shekratul10/EEProject/README.md

# Group 5/ASHB's EE Project 2022 

## [Written report](https://imperiallondon-my.sharepoint.com/:w:/g/personal/an521_ic_ac_uk/EeuObOR-S-lHpdSKYnU6FhYBMaKFVtId1mpSv_Idt-HmbQ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)
## [project mark scheme](https://github.com/shekratul10/EEProject/blob/main/Written%20report/EDP%20-%20final%20report%20mark%20sheet%202022%20-%20Copy.xlsx)
## [Video](https://imperiallondon-my.sharepoint.com/:v:/g/personal/eperea_ic_ac_uk/EdCU5DJ8DUpJqPFEcV0eLp4B5TmBCVaoO-RB1G3f6M7Cjg)
## [Video Demo](https://imperiallondon-my.sharepoint.com/:v:/g/personal/rs2221_ic_ac_uk/EedtrnN3LAxCjQFRvVvkyTYB7NkDGX7jUrfwkagcI3mQWg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)

## User Interface


## Important 
- Make component orders at https://apps.powerapps.com/play/30b4e212-d040-4203-98cc-882acb4edee0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 if necessary
- **We should wear suits or other formal wear to the demo for 24/06/22**
- Be aware that digital pins 5,7 & 10 cannot be used on the Adafruit board

The following needs to be **accomplished** to meet our project goals:
- [x] Develop a circuit to detect acoustic signals and analyse the frequency
- [x] Develop a circuit to detect infrared pulses and analyse the pulse frequency
- [x] Develop a circuit to detect magnetic field polarity and analyse the direction of the field
- [x] Develop a circuit to detect radio waves, detect the carrier frequency, detect the modulating frequency and analyse these frequencies
- [x] Establish motor control of the EEE Rover
- [x] Establish a web interface to control the motion of the EEE Rover as well as display the data gathered from the sensors
- [x] Consider CAD-based methods to improve the design of the EEE Rover
- [x] Conduct testing for each sensor and motor control
- [x] Produce a written report for each section, combine the reports and edit the combined document
- [x] Review the combined written report for final adjustments
- [x] Submit the final written report

## Useful information
Mineral properties:


Exorock operating switches:



## Acoustic sensing
Resources have been moved here: [Ultrasound](https://github.com/shekratul10/EEProject/tree/main/Sensor/Ultrasound)
## IR Pulse sensing
Resources have been moved here: [IR Pulse](https://github.com/shekratul10/EEProject/tree/main/Sensor/IR%20Pulse)
## Magnetic field sensing
Resources have been moved here: [Magnetic field](https://github.com/shekratul10/EEProject/tree/main/Sensor/Magnetic%20field)
## Radio wave sensing
Resources have been moved here: [Radio Wave](https://github.com/shekratul10/EEProject/tree/main/Sensor/Radio%20Wave)
## Written Report
Resources have been moved here: [Written Report](https://github.com/shekratul10/EEProject/tree/main/Written%20report)
