shekratul10/EEProject/Sensor/README.md

# Please submit appropriate code to the corresponding sensor and change the checklist as you make progress with the sensor
