shekratul10/EEProject/Sensor/Magnetic field/README.md

## Magnetic field detecting sensor

- [x] Determine a suitable soln. to detect magnetic field
- [x] Determine a suitable sensor to detect magnetic field
- [x] Place order for the chosen sensor
- [x] Approve order for the chosen sensor
- [x] Design circuit to detect magnetic field
- [ ] Analyse results from the circuit
- [ ] Upload the results to the web interface/app

**Use of a hall effect sensor may be better instead.**
The circuit required to detect the magntic field is easier to implement when considering the two poles that need to be analysed. Information for reed switching will remain here until we have a better idea of which sensor is better for this purpose. Example circuit: https://circuitdigest.com/electronic-circuits/magnetic-polarity-detector-circuit-using-hall-sensor. Here are resources for using the hall effect sensor instead: https://www.electronics-tutorials.ws/electromagnetism/hall-effect.html , https://uk.rs-online.com/web/generalDisplay.html?id=ideas-and-advice/hall-effect-sensors-guide.

We could use the bipolar HS (DRV5053EAQLPGM) to detect if there is a magnetic field via analogue analysis. VQ is the "middle ground" between north and south poles, quoted with a value between 0.9-1.2 V as manufacturing tolerances. To detect a magnetic field we need to determine if the voltage from the bipolar analogue input is outside a certain voltage region e.g. 0.7 - 1.5 V then a magnetic field is detected. Datasheet for reference: https://www.ti.com/lit/ds/symlink/drv5053.pdf?HQS=dis-dk-null-digikeymode-dsf-pf-null-wwe&ts=1654186442426

We could use the unipolar HS (SS441R) to detect the polarity of the magnetic field. This produces a digital signal and responds in the presence of a South pole (0 for north and 1 for south). Will be used to determine the polarity of the field. Datasheet for reference: https://www.farnell.com/datasheets/2012747.pdf 

Here is some logic that can be implemented to determine the magnetic field polarity:



**I have heard that the pins on the hall effect sensor are rather delicate therefore two of each kind will be ordered.**

The ordered sensors:

Bipolar: https://onecall.farnell.com/texas-instruments/drv5053eaqlpgm/hall-effect-bipolar-to-92-3/dp/3124148

Unipolar: https://onecall.farnell.com/honeywell/ss441r/sensor-hall-effect-unipolar-to/dp/1784735 

Proposed circuit will HS: 

circuit-2

Resistor values have been chosen to ensure the current limits of the components are not reached, allowing for safe operation without damaging the components. 

Useful information:
- https://www.ti.com/lit/an/slia086a/slia086a.pdf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
- you could just use the analogue hall effect sensor
