shekratul10/EEProject/Written report/Final written report plan.md

Page 1
> Cover page

Page 2
> Blank page

Page 3
> Table of contents page

Page 4
> Project brief

Page 5
> Gantt chart (initial)

Page 6
> [Import] Product specification

Page 7
> [Import] IR written report

Page 8
> [Import] Magnetic field written report

Page 9
> [Import] Radio wave written report

Page 10
> [Import] Ultrasound written report

Page 11
> [Import] Motor control written report

Page 12
> [Import] Website written report

Page 13
> [Import] Construction of circuits written report

Page 14
> [Import] CAD + chassis written report

Page 15
> [Import] Testing of cummulative functions written report

Page 16
> [Import] Final Rover

Page 17
> [Import] Evaluation

Page 18
> [Import] References
