shekratul10/EEProject/Sensor/physical circuits.md

## See the written report for this section

All sensor circuits should be built on stripboards since the connections are more secure, stripboards are better use for space, smaller, thinner and lighter than breadboards. Additional advantages in the written report and a useful website on how to use stripboards can be found in the references (Ref 6). 

Datasheet of stripboard as well as component: 

Datasheet: https://www.farnell.com/datasheets/1998175.pdf (E012)
Component: https://onecall.farnell.com/kemo-electronic/e012/stripboard-fr2-100x100mm/dp/2503759?st=veroboard

Fuck no farnell charges absurd handling fees, RS components are better:
https://uk.rs-online.com/web/p/stripboards/2065841

There are several circuits that have been soldered to the stripboards such as the infrared and ultrasound sensing circuits. These circuits work as intended with Vcc, GND and signal wires as actual wire components. The length of the wires can be changed either by cutting them to size or replacing them with wires of appropriate size. The Vcc and GND wires will be soldered to another stripboard that will act as a power distributor board, featuring rails for 3.3 V, 5 V and GND, which will have connections to the breadboard. 

Written report: [construction of circuits](https://github.com/shekratul10/EEProject/blob/main/Written%20report/Construction%20of%20circuits%20written%20report.docx)
