shekratul10/EEProject/Written report/Final written report.docx

ELEC 40006 Electronics Design Project

2022

Group 5, ASHB

[NAMES]

# Project Brief

# Gantt Chart/planning

# Product Specification

# Sensors

## Acoustic

## Infrared

## Magnetic

## Radio

# Motor control

# Web Interface

# CAD

# Overall testing

# Evaluation against specification

# Project Evaluation

# References

# Appendix
