shekratul10/EEProject/Written report/EDP - final report mark sheet 2022 - Copy.xlsx

ELEC40006 Electronics Design Project
Final report Marking Scheme
Group members:
 |  | Marker:
Max marks | Review Criteria | Grade | Marks
 | Engineering Design Process
 | Outline of the technical problem to be solved
5% | Design criteria (main points of the PDS)
 | Overview of the design (high level design and detail design)
20% | Design process - how did you get from problem to solution?
 | Conclusions / recommendations for future work
 | Project management and planning (aims, milestones, final project plan, meeting structure)
5% | Critical analysis (what did you do when things went wrong? and when they worked?)
5% | Reflection
 | Report
15% | Structure and writing (logical structure, easy to follow logic)
 | Grammar and spelling
 | Report presentation
 | References (including Figures, pictures and graphs)
 | Technical progress
20% | Functionality:
 | · Design meets specifications
 | · Use of theory and literature to underpin design decisions
 | · Correct and optimal implementation
10% | Evaluation:
 | · Use of appropriate metrics to evaluate the solution
 | · Adequate testing to reveal strengths and weaknesses of the design
 | · Results and interpretation
20% | Innovative engineering for improving functionality, quality, performance, cost and energy consumption: applying self-researched and/or novel solutions to develop and exceed the specifications
Please provide 3 points of feedback:
1.
2.
3
