shekratul10/EEProject/(commit log)

2022-05-27 Separate Webpage
    Now uses separate webpage (page.html) . The one in the ino file while is hosted at the URL will only be used for debugging from now on. The new page uses a separate style sheet.
    Input can now be detected and webpage updated based on changing inputs. Outputs can also be changed based on button presses
    Radio sensor connects to port 8,
    Magnetic sensor connects to port 9,
    IR Sensor connects to port 13
2022-05-27 Polarity of Magnetic Sensor
    We can now detect the polarity of the magnetic input using analogRead.
2022-05-31 Create Magnetic Sensor.md
2022-05-31 Update Magnetic Sensor.md
2022-05-31 Create IR Sensing circuit.md
2022-05-31 Update IR Sensing circuit.md
2022-05-31 Create Ultrasound circuit.md
2022-06-01 Rename Ultrasound circuit.md to README.md
2022-06-01 Rename IR Sensing circuit.md to README.md
2022-06-01 Rename Magnetic sensor.md to README.md
2022-06-05 Create physical circuits.md
2022-06-05 Update physical circuits.md
2022-06-05 Create radio sensor
2022-06-06 Update to motor control code
2022-06-12 update to sensor code
2022-06-12 Updated motor control
    Now supports 8 direction movement and is generally faster.
2022-06-14 Add files via upload
    added motor controls
2022-06-16 Magnetic, IR and US sensors working with interface , Drive also now workin
2022-06-18 Added functionality for camera
    The camera can now be displayed using a webcam there is also code for using an ip camera that we can also make use of.
2022-06-24 Rover Camera UI
    This is an updated version of the UI designed to work with a camera attached to the rover. The controls have increased in size making them easier to use. The sensors information has now been placed to the side to make room for the camera feed. The UI now features an acrylic material.
2022-06-24 Configuration selecting specific camera
    I adjusted the code from the previous version so that it selects the camera attached to the rover.
